14chanwa/AppartIntelligent/PCB/PlantWatering/PlantWatering.kicad_pcb

## KiCad design PCB/PlantWatering/PlantWatering.kicad_pcb (2025-07-27)

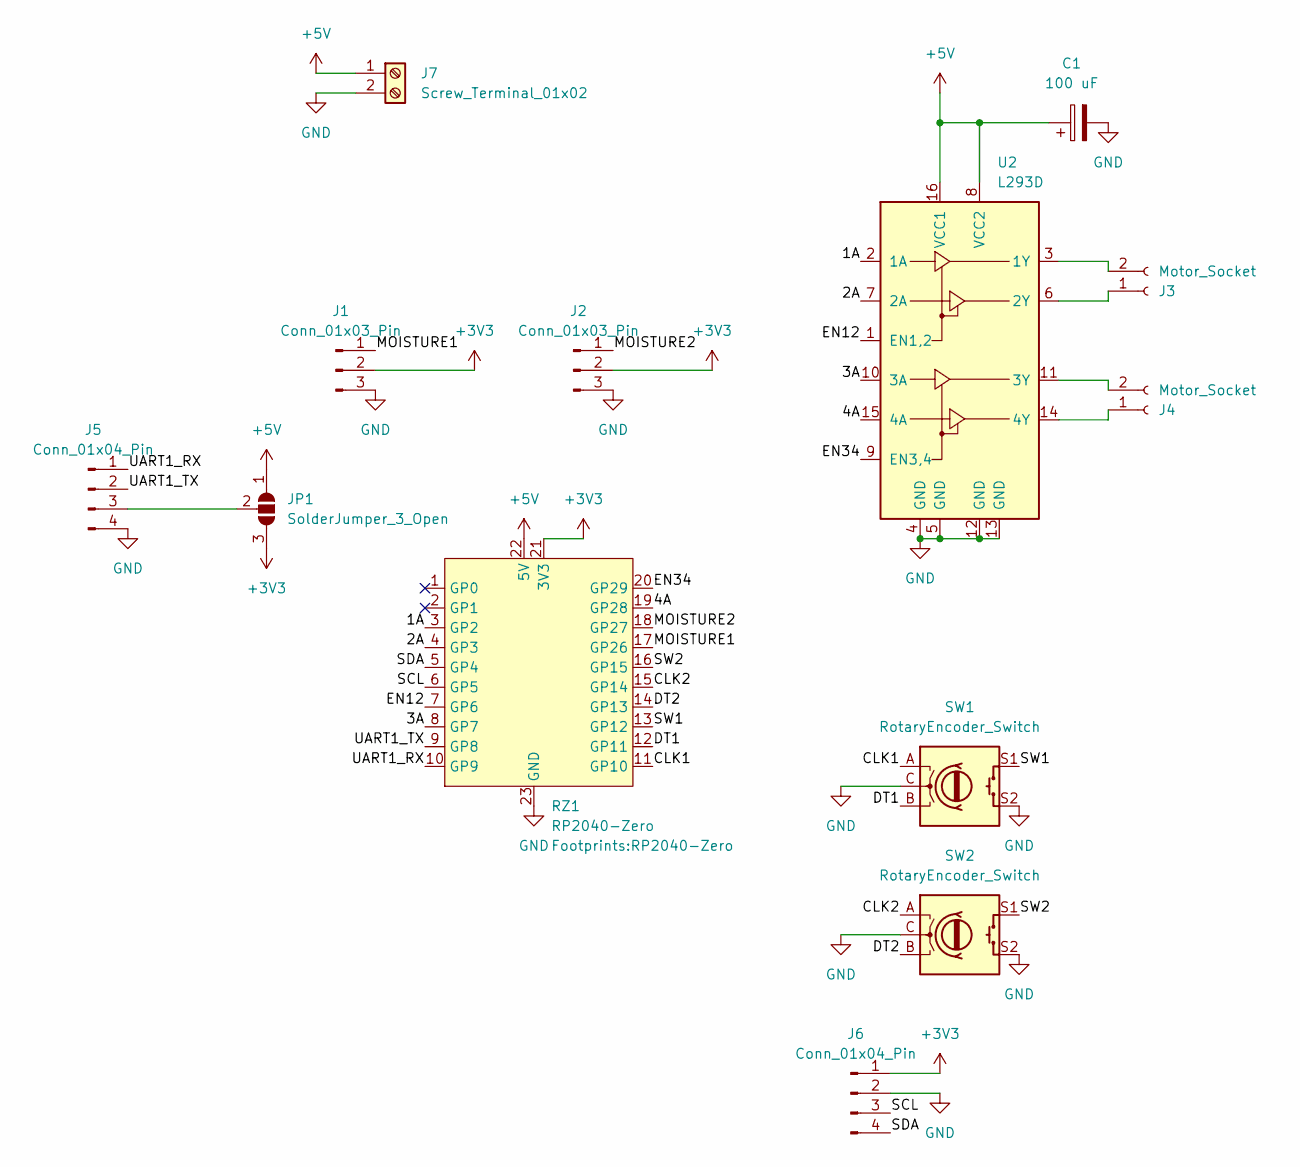
[picture p1: schematic PlantWatering.kicad_sch]

Parts:
C1: 100 uF; CP_Radial_D5.0mm_P2.50mm
J1, J2: Conn_01x03_Pin; PinHeader_1x03_P2.54mm_Vertical
J3, J4: Motor_Socket; PumpWatering
J5: Conn_01x04_Pin; PinHeader_1x04_P2.54mm_Vertical
J6: Conn_01x04_Pin; SSD1306
J7: Screw_Terminal_01x02; USBC-Dummy-Card
JP1: SolderJumper_3_Open; SolderJumper-3_P1.3mm_Open_RoundedPad1.0x1.5mm_NumberLabels
RZ1: RP2040-Zero
SW1, SW2: RotaryEncoder_Switch; RotaryEncoder_Alps_EC11E-Switch_Vertical_H20mm
U2: L293D; DIP-16_W7.62mm

Connections:
+3V3: J1.2, J2.2, J6.1, JP1.3 (B), RZ1.21 (3V3)
+5V: C1.1, J7.1, JP1.1 (A), RZ1.22 (5V), U2.8 (VCC2), U2.16 (VCC1)
/1A: RZ1.3 (GP2), U2.2 (1A)
/2A: RZ1.4 (GP3), U2.7 (2A)
/3A: RZ1.8 (GP7), U2.10 (3A)
/4A: RZ1.19 (GP28), U2.15 (4A)
/CLK1: RZ1.11 (GP10), SW1.A
/CLK2: RZ1.15 (GP14), SW2.A
/DT1: RZ1.12 (GP11), SW1.B
/DT2: RZ1.14 (GP13), SW2.B
/EN12: RZ1.7 (GP6), U2.1 (EN1,2)
/EN34: RZ1.20 (GP29), U2.9 (EN3,4)
/MOISTURE1: J1.1, RZ1.17 (GP26)
/MOISTURE2: J2.1, RZ1.18 (GP27)
/SCL: J6.3, RZ1.6 (GP5)
/SDA: J6.4, RZ1.5 (GP4)
/SW1: RZ1.13 (GP12), SW1.S1
/SW2: RZ1.16 (GP15), SW2.S1
/UART1_RX: J5.1, RZ1.10 (GP9)
/UART1_TX: J5.2, RZ1.9 (GP8)
GND: C1.2, J1.3, J2.3, J5.4, J6.2, J7.2, RZ1.23 (GND), SW1.C, SW1.S2, SW2.C, SW2.S2, U2.4 (GND), U2.5 (GND), U2.12 (GND), U2.13 (GND)
unnamed: J3.1, U2.6 (2Y)
unnamed: J3.2, U2.3 (1Y)
unnamed: J4.1, U2.14 (4Y)
unnamed: J4.2, U2.11 (3Y)
unnamed: J5.3, JP1.2 (C)

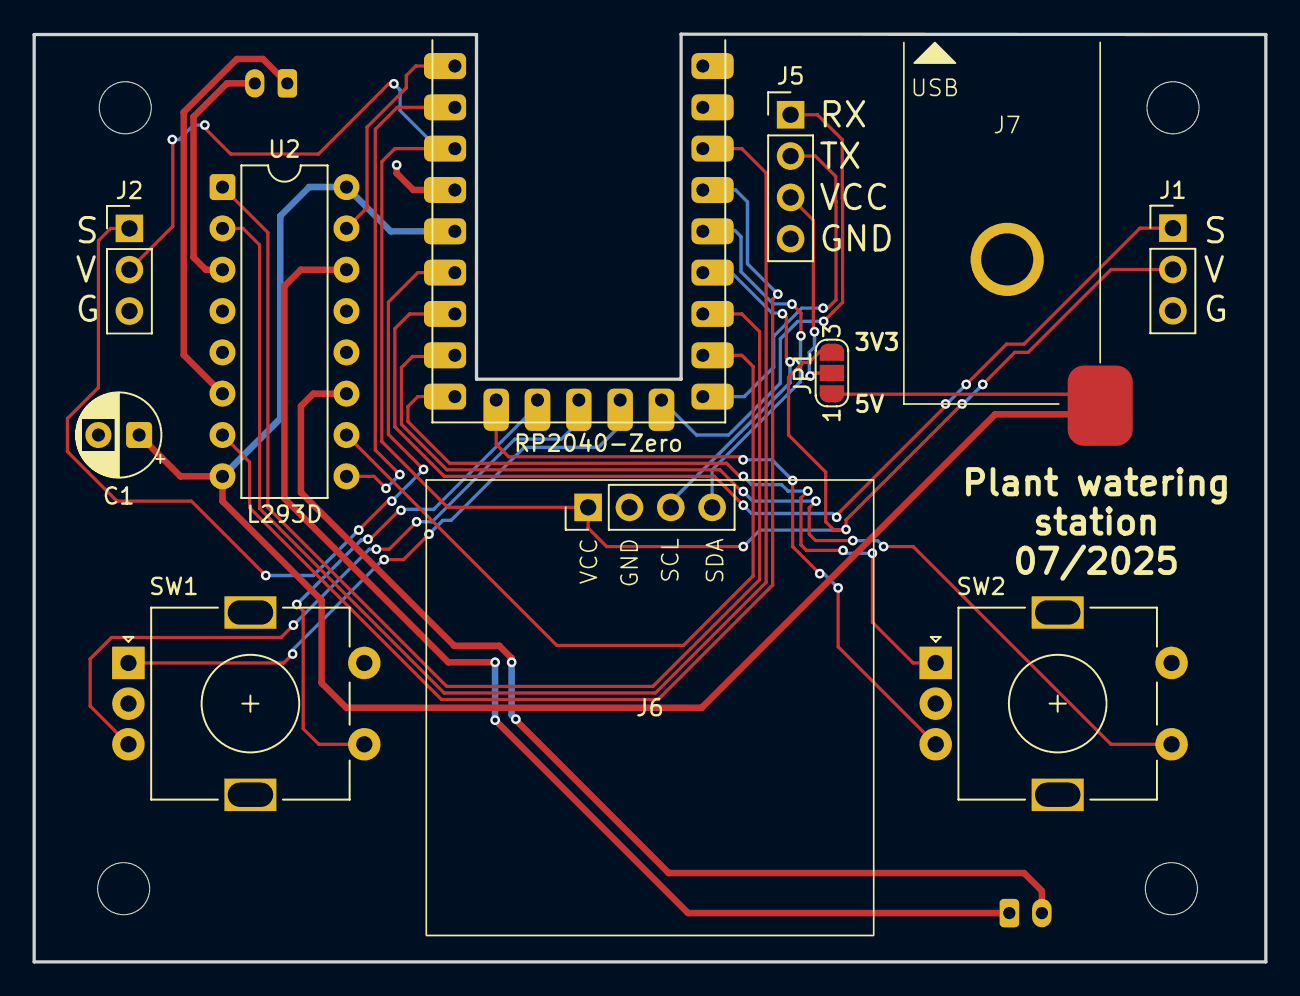
[picture p2: board PlantWatering.kicad_pcb from above]

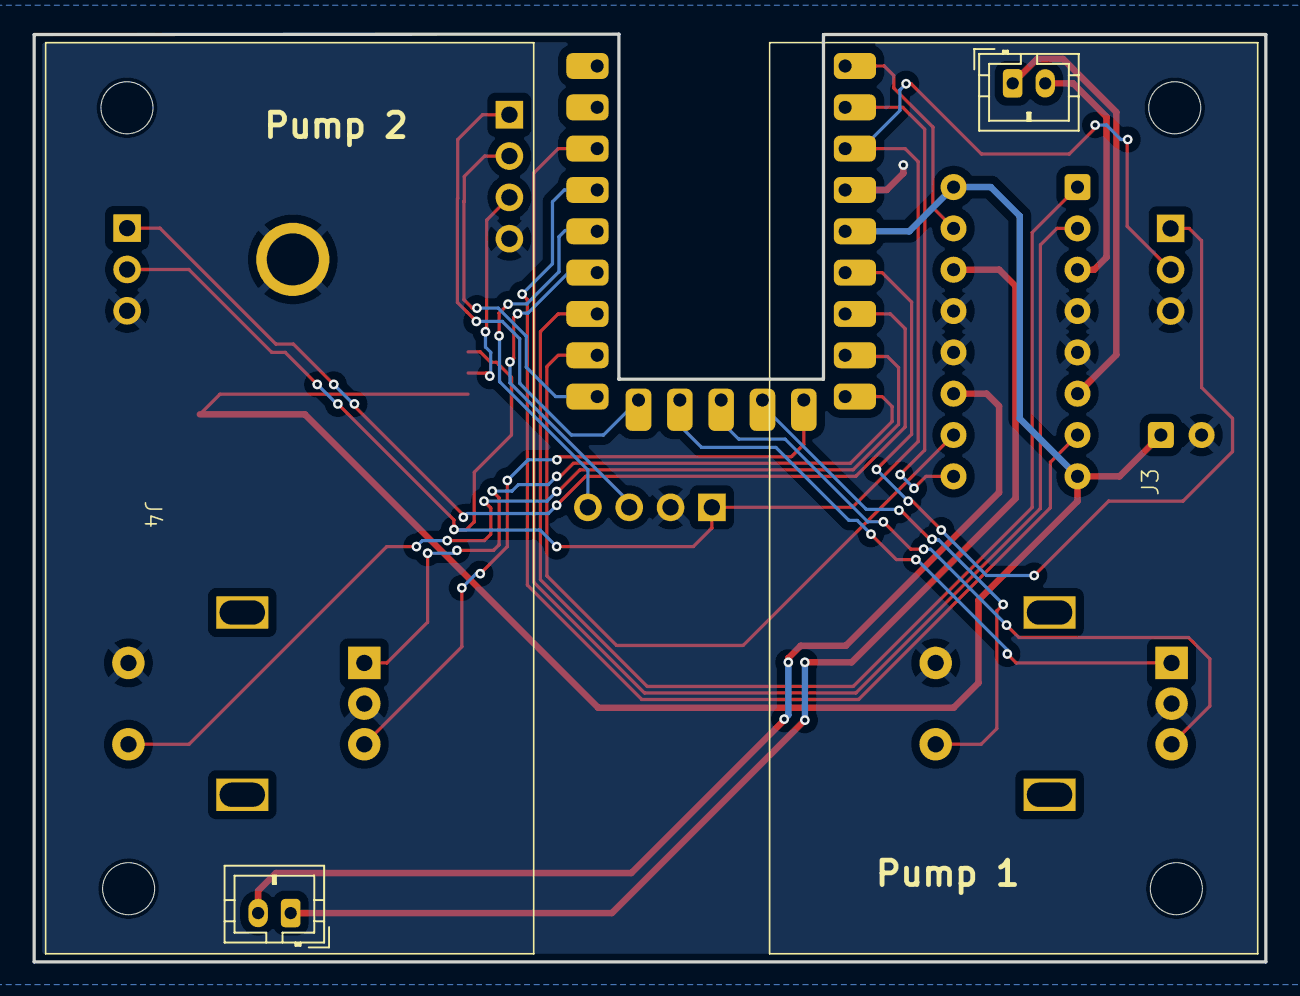
[picture p3: board PlantWatering.kicad_pcb from below]

Board: 2 copper layers, 75.7 x 57.0 mm, 13 parts (2 on the bottom side), 26 nets.
