14chanwa/AppartIntelligent/PCB/CapteurConnecte/CapteurConnecte.kicad_pcb

## KiCad design PCB/CapteurConnecte/CapteurConnecte.kicad_pcb (2025-07-27)

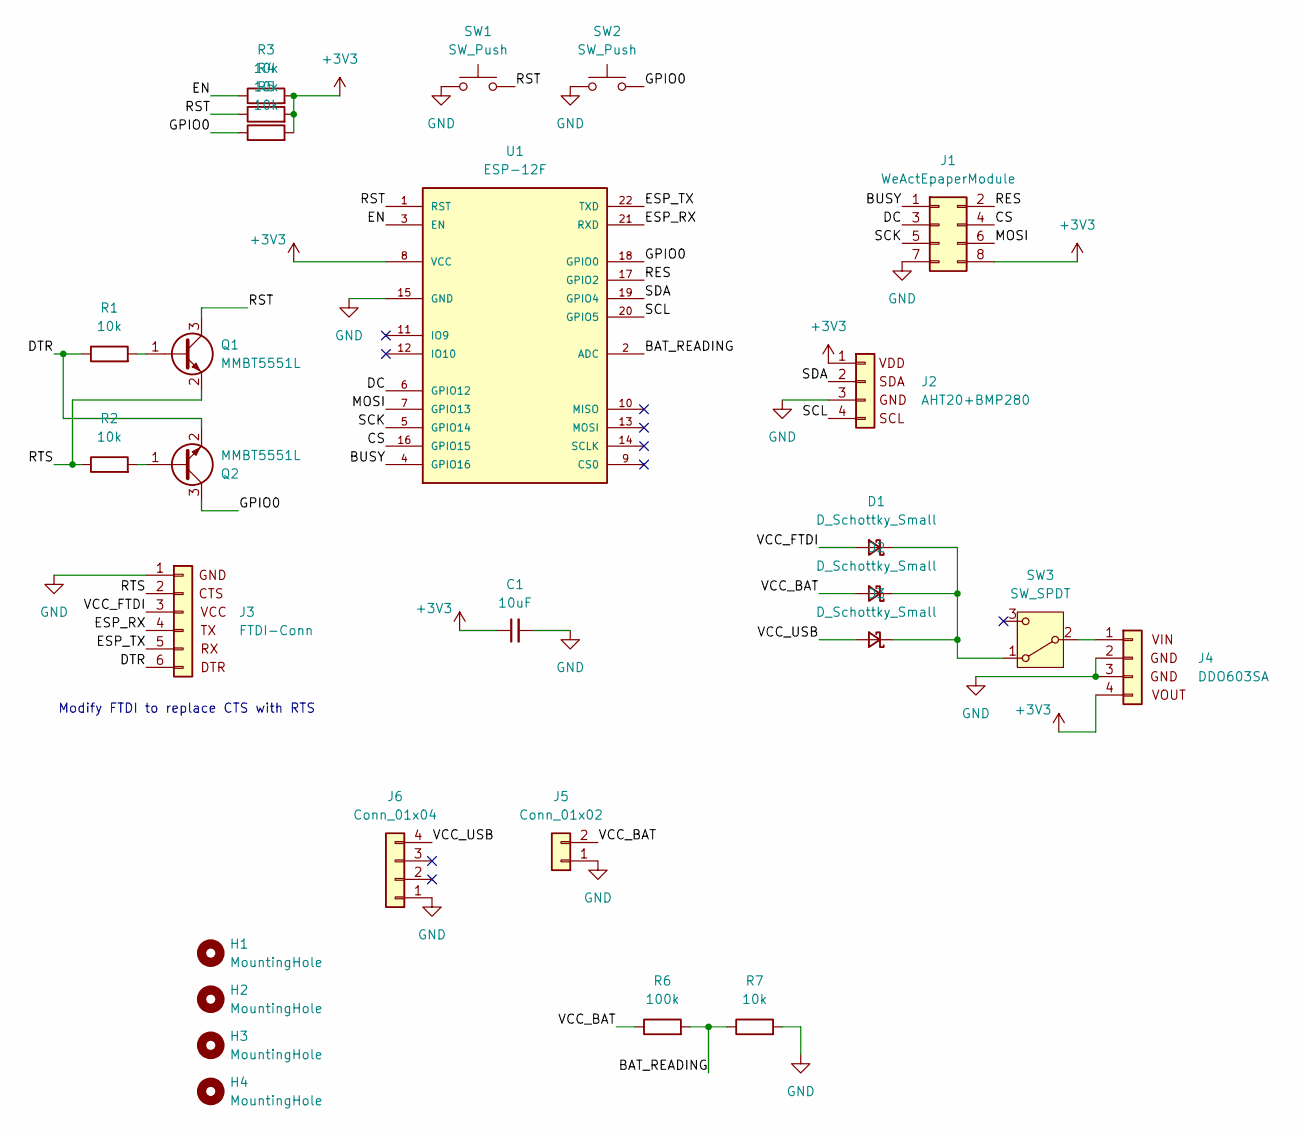
[picture p4: schematic CapteurConnecte.kicad_sch]

Parts:
C1: 10uF; CP_Radial_D4.0mm_P1.50mm
D1, D2, D3: D_Schottky_Small; D_SOD-323_HandSoldering
H1, H2, H3, H4: MountingHole; MountingHole_3.2mm_M3
J1: WeActEpaperModule; PinHeader_2x04_P2.54mm_Vertical
J2: AHT20+BMP280
J3: FTDI-Conn; FTDI-breakout
J4: DDO603SA; DD0603SB
J5: Conn_01x02; JST_PH_B2B-PH-K_1x02_P2.00mm_Vertical
J6: Conn_01x04; USBC-breakout
Q1, Q2: MMBT5551L; SOT-23
R1, R2, R3, R4, R5, R7: 10k; R_0805_2012Metric_Pad1.20x1.40mm_HandSolder
R6: 100k; R_0805_2012Metric_Pad1.20x1.40mm_HandSolder
SW1, SW2: SW_Push; SW_SPST_CK_RS282G05A3
SW3: SW_SPDT; SliderSwitch
U1: ESP-12F

Connections:
+3V3: C1.1, J1.8, J2.1, J4.4, R3.2, R4.2, R5.2, U1.8 (VCC)
/BAT_READING: R6.2, R7.1, U1.2 (ADC)
/BUSY: J1.1, U1.4 (GPIO16)
/CS: J1.4, U1.16 (GPIO15)
/DC: J1.3, U1.6 (GPIO12)
/DTR: J3.6, Q2.2 (E), R1.1
/EN: R3.1, U1.3 (EN)
/ESP_RX: J3.4, U1.21 (RXD)
/ESP_TX: J3.5, U1.22 (TXD)
/GPIO0: Q2.3 (C), R5.1, SW2.2, U1.18 (GPIO0)
/MOSI: J1.6, U1.7 (GPIO13)
/RES: J1.2, U1.17 (GPIO2)
/RST: Q1.3 (C), R4.1, SW1.2, U1.1 (RST)
/RTS: J3.2, Q1.2 (E), R2.1
/SCK: J1.5, U1.5 (GPIO14)
/SCL: J2.4, U1.20 (GPIO5)
/SDA: J2.2, U1.19 (GPIO4)
/VCC_BAT: D2.2 (A), J5.2, R6.1
/VCC_FTDI: D1.2 (A), J3.3
/VCC_USB: D3.2 (A), J6.4
GND: C1.2, J1.7, J2.3, J3.1, J4.2, J4.3, J5.1, J6.1, R7.2, SW1.1, SW2.1, U1.15 (GND)
unnamed: D1.1 (K), D2.1 (K), D3.1 (K), SW3.1 (A)
unnamed: J4.1, SW3.2 (B)
unnamed: Q1.1 (B), R1.2
unnamed: Q2.1 (B), R2.2

Notes on the sheet:
Modify FTDI to replace CTS with RTS

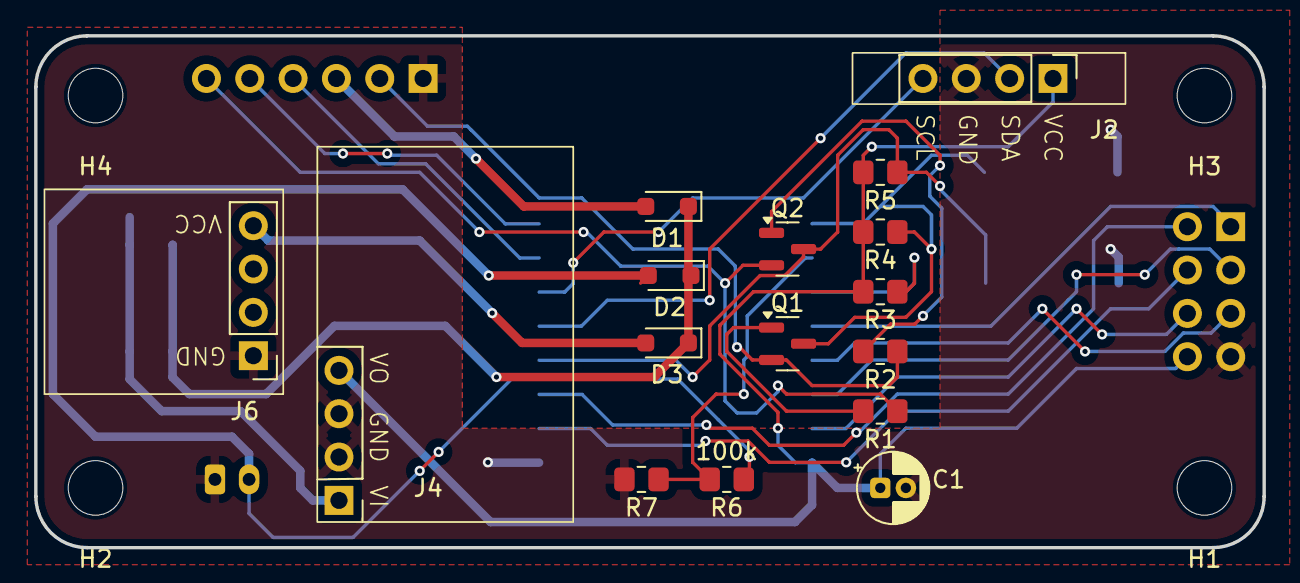
[picture p5: board CapteurConnecte.kicad_pcb from above]

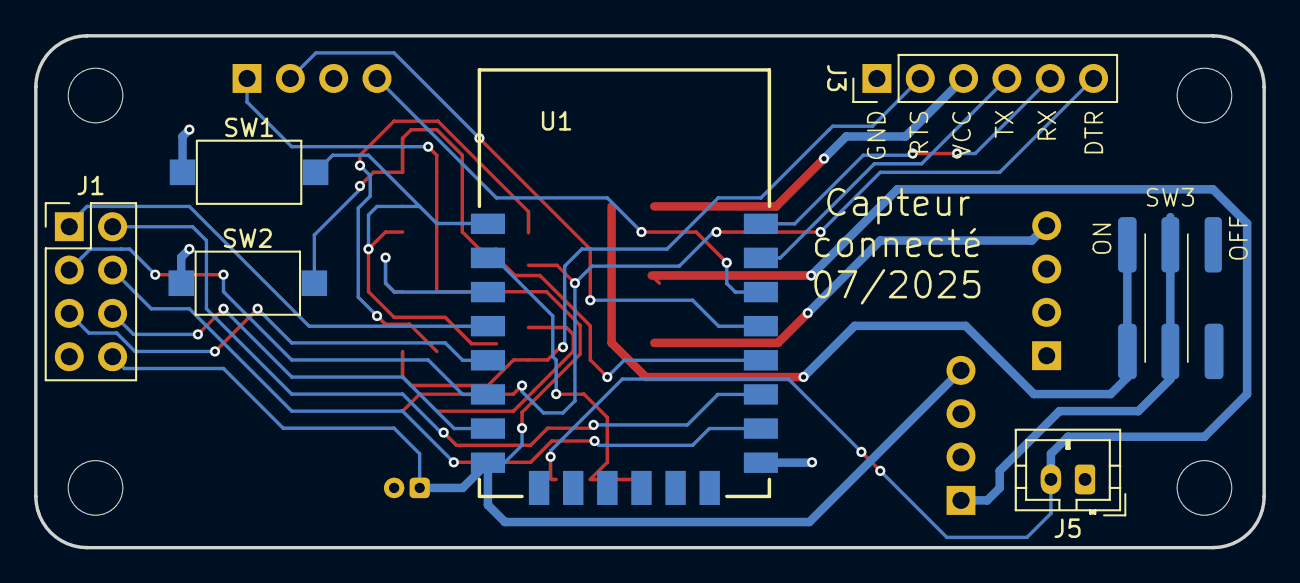
[picture p6: board CapteurConnecte.kicad_pcb from below]

Board: 2 copper layers, 72.0 x 30.0 mm, 27 parts (7 on the bottom side), 25 nets.
